mikusnt/M.O.C./Eagle/MOC/moc.brd

## EAGLE design Eagle/MOC/moc.brd (2019-04-15)

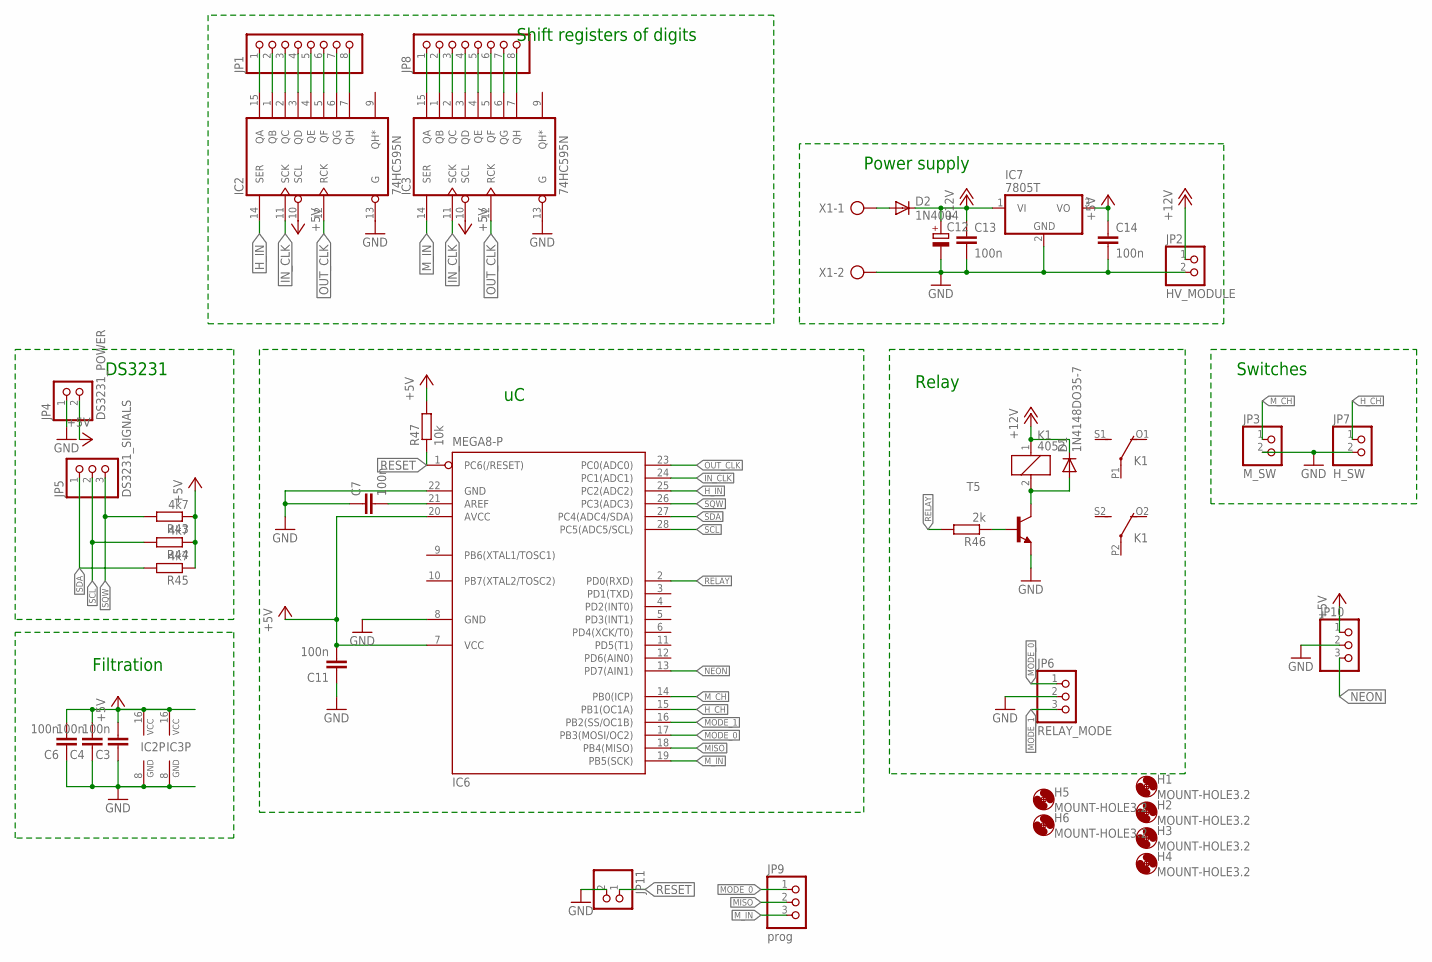
[picture p1: schematic moc.sch]

Parts:
C3, C4, C6, C7, C11, C13, C14: 100n; C025-025X050
C12: CPOL-EUE3.5-8; E3,5-8
D1: 1N4148DO35-7; DO35-7
D2: 1N4004; DO41-10
H1, H2, H3, H4, H5, H6: MOUNT-HOLE3.2; 3,2
IC2, IC3: 74HC595N; DIL16
IC6: MEGA8-P; DIL28-3
IC7: 7805T; TO220H
JP1, JP8: PINHD-1X8; 1X08
JP2: HV_MODULE; 1X02
JP3: M_SW; 1X02
JP4: DS3231_POWER; 1X02
JP5: DS3231_SIGNALS; 1X03
JP6: RELAY_MODE; 1X03
JP7: H_SW; 1X02
JP9: prog; 1X03
JP10: PINHD-1X3; 1X03
JP11: PINHD-1X2/90; 1X02/90
K1: 4052; F4052
R43, R44, R45: 4k7; 0207/10
R46: 2k; 0207/7
R47: 10k; 0207/10
T5: BC337-16-NPN-TO92-CBE; TO92-CBE
X1: AK300/2

Connections:
+5V: C3.2, C4.2, C6.2, C11.2, C14.1, IC2.10 (SCL), IC2.16 (VCC), IC3.10 (SCL), IC3.16 (VCC), IC6.7 (VCC), IC6.20 (AVCC), IC7.3 (VO), JP4.2, JP10.1, R43.1, R44.1, R45.1, R47.2
+12V: C12.+, C13.1, D1.C, D2.C, IC7.1 (VI), JP2.1, K1.1
D8: IC3.7 (QH), JP8.8
D9: IC3.6 (QG), JP8.7
D10: IC3.5 (QF), JP8.6
D11: IC3.4 (QE), JP8.5
D12: IC3.3 (QD), JP8.4
D13: IC3.2 (QC), JP8.3
D14: IC3.1 (QB), JP8.2
D15: IC3.15 (QA), JP8.1
D16: IC2.7 (QH), JP1.8
D17: IC2.6 (QG), JP1.7
D18: IC2.5 (QF), JP1.6
D19: IC2.4 (QE), JP1.5
D20: IC2.3 (QD), JP1.4
D21: IC2.2 (QC), JP1.3
D22: IC2.1 (QB), JP1.2
D23: IC2.15 (QA), JP1.1
GND: C3.1, C4.1, C6.1, C7.1, C11.1, C12.-, C13.2, C14.2, IC2.8 (GND), IC2.13 (G), IC3.8 (GND), IC3.13 (G), IC6.8 (GND), IC6.22 (GND), IC7.2 (GND), JP2.2, JP3.2, JP4.1, JP6.2, JP7.2, JP10.2, JP11.2, T5.E, X1.2
H_CH: IC6.15 (PB1(OC1A)), JP7.1
H_IN: IC2.14 (SER), IC6.25 (PC2(ADC2))
IN_CLK: IC2.11 (SCK), IC3.11 (SCK), IC6.24 (PC1(ADC1))
MISO: IC6.18 (PB4(MISO)), JP9.2
MODE_0: IC6.17 (PB3(MOSI/OC2)), JP6.1, JP9.1
MODE_1: IC6.16 (PB2(SS/OC1B)), JP6.3
M_CH: IC6.14 (PB0(ICP)), JP3.1
M_IN: IC3.14 (SER), IC6.19 (PB5(SCK)), JP9.3
unnamed: D2.A, X1.1
unnamed: C7.2, IC6.21 (AREF)
unnamed: D1.A, K1.2, T5.C
unnamed: R46.1, T5.B
NEON: IC6.13 (PD7(AIN1)), JP10.3
OUT_CLK: IC2.12 (RCK), IC3.12 (RCK), IC6.23 (PC0(ADC0))
RELAY: IC6.2 (PD0(RXD)), R46.2
RESET: IC6.1 (PC6(/RESET)), JP11.1, R47.1
SCL: IC6.28 (PC5(ADC5/SCL)), JP5.2, R44.2
SDA: IC6.27 (PC4(ADC4/SDA)), JP5.1, R45.2
SQW: IC6.26 (PC3(ADC3)), JP5.3, R43.2

Notes on the sheet:
DS3231
Relay
Power supply
Filtration
Shift registers of digits
Switches

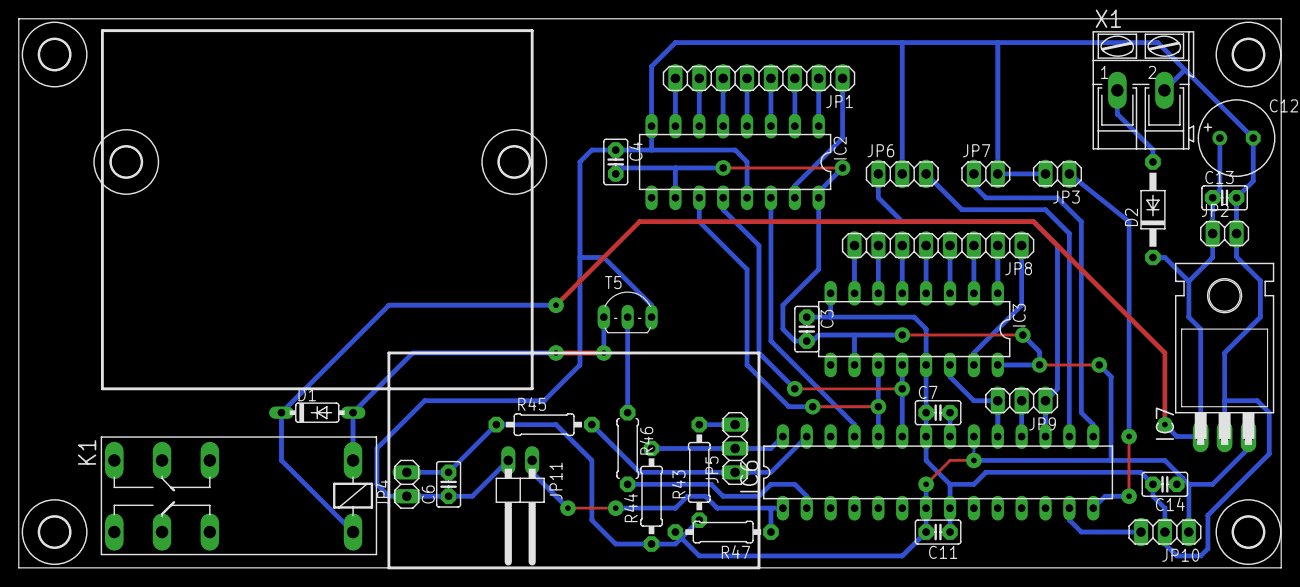
[picture p2: board moc.brd from above]

Board: 2 copper layers, 134.3 x 58.4 mm, 39 parts (0 on the bottom side), 38 nets.
