mikusnt/M.O.C./Eagle/MOC/moc2.brd

## EAGLE design Eagle/MOC/moc2.brd (2019-03-03)

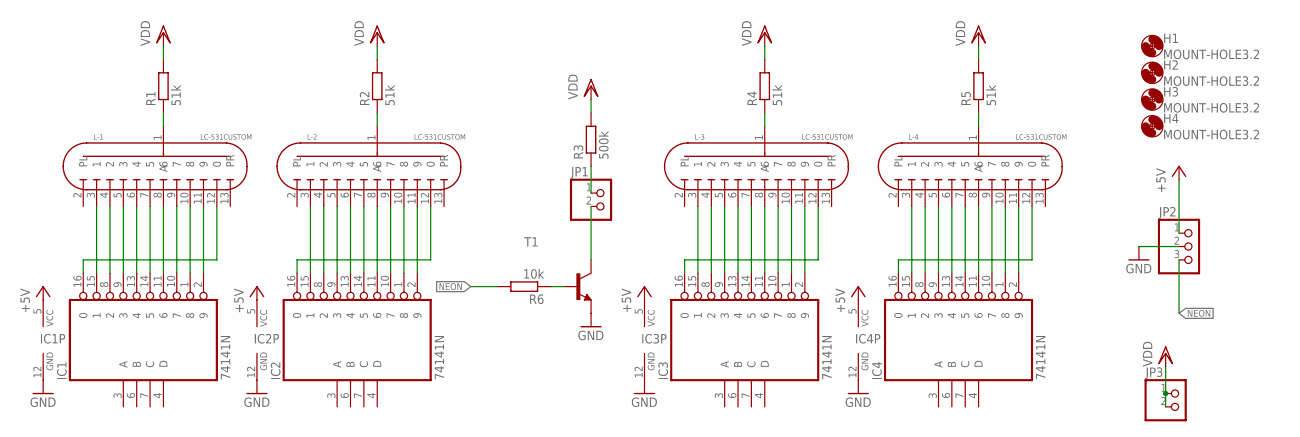
[picture p3: schematic moc2.sch]

Parts:
H1, H2, H3, H4: MOUNT-HOLE3.2; 3,2
IC1, IC2, IC3, IC4: 74141N; DIL16
JP1: PINHD-1X2; 1X02
JP2: PINHD-1X3/90; 1X03/90
JP3: PINHD-1X2/90; 1X02/90
L-1, L-2, L-3, L-4: LC-531CUSTOM; LC-531_PIN_SOCKET
R1, R2, R4, R5: 51k; 0207/10
R3: 500k; 0207/10
R6: 10k; 0207/10
T1: BF422-NPN-TO92-BCE; TO92-BCE

Connections:
+5V: IC1.5 (VCC), IC2.5 (VCC), IC3.5 (VCC), IC4.5 (VCC), JP2.1
GND: IC1.12 (GND), IC2.12 (GND), IC3.12 (GND), IC4.12 (GND), JP2.2, T1.E
unnamed: IC1.15 (1), L-1.3 (1)
unnamed: IC1.8 (2), L-1.4 (2)
unnamed: IC1.9 (3), L-1.5 (3)
unnamed: IC1.13 (4), L-1.6 (4)
unnamed: IC1.14 (5), L-1.7 (5)
unnamed: IC1.11 (6), L-1.8 (6)
unnamed: IC1.10 (7), L-1.9 (7)
unnamed: IC1.1 (8), L-1.10 (8)
unnamed: IC1.2 (9), L-1.11 (9)
unnamed: IC1.16 (0), L-1.12 (0)
unnamed: L-1.1 (A), R1.1
unnamed: IC2.15 (1), L-2.3 (1)
unnamed: IC2.8 (2), L-2.4 (2)
unnamed: IC2.9 (3), L-2.5 (3)
unnamed: IC2.13 (4), L-2.6 (4)
unnamed: IC2.14 (5), L-2.7 (5)
unnamed: IC2.11 (6), L-2.8 (6)
unnamed: IC2.10 (7), L-2.9 (7)
unnamed: IC2.1 (8), L-2.10 (8)
unnamed: IC2.2 (9), L-2.11 (9)
unnamed: IC2.16 (0), L-2.12 (0)
unnamed: L-2.1 (A), R2.1
unnamed: JP1.2, T1.C
unnamed: JP1.1, R3.1
unnamed: IC3.15 (1), L-3.3 (1)
unnamed: IC3.8 (2), L-3.4 (2)
unnamed: IC3.9 (3), L-3.5 (3)
unnamed: IC3.13 (4), L-3.6 (4)
unnamed: IC3.14 (5), L-3.7 (5)
unnamed: IC3.11 (6), L-3.8 (6)
unnamed: IC3.10 (7), L-3.9 (7)
unnamed: IC3.1 (8), L-3.10 (8)
unnamed: IC3.2 (9), L-3.11 (9)
unnamed: IC3.16 (0), L-3.12 (0)
unnamed: L-3.1 (A), R4.1
unnamed: IC4.15 (1), L-4.3 (1)
unnamed: IC4.8 (2), L-4.4 (2)
unnamed: IC4.9 (3), L-4.5 (3)
unnamed: IC4.13 (4), L-4.6 (4)
unnamed: IC4.14 (5), L-4.7 (5)
unnamed: IC4.11 (6), L-4.8 (6)
unnamed: IC4.10 (7), L-4.9 (7)
unnamed: IC4.1 (8), L-4.10 (8)
unnamed: IC4.2 (9), L-4.11 (9)
unnamed: IC4.16 (0), L-4.12 (0)
unnamed: L-4.1 (A), R5.1
unnamed: R6.1, T1.B
NEON: JP2.3, R6.2
VDD: JP3.1, JP3.2, R1.2, R2.2, R3.2, R4.2, R5.2

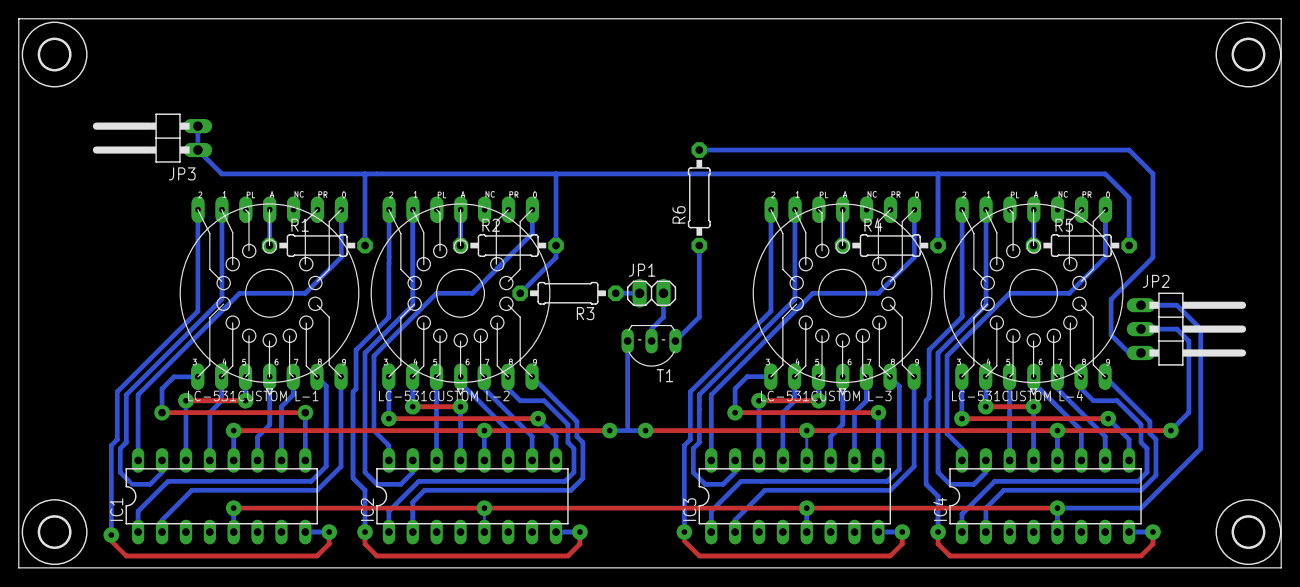
[picture p4: board moc2.brd from above]

Board: 2 copper layers, 134.3 x 58.4 mm, 22 parts (0 on the bottom side), 51 nets.
