mikusnt/M.O.C./todo.md

## Basic Tasks
- [x] project structure
- [x] Eagle schematics
- [x] buying parts
- [ ] design of case
- [x] basic functionality
- [x] rename digits slowly
- [x] hardware tests
- [x] all cathodes heat on

## Extended Tasks  
- [x] some modes of relay
- [ ] chroma steel case
