mikusnt/M.O.C./devices/relay.c

/*!
 * @file relay.c
 * @author 		Mikolaj Stankowiak <br>
 * 				mik-stan@go2.pl
 * @see relay.h*/

#include "relay.h"

uint8_t eeRelayState EEMEM = RelaySilent;

/*
 *
 *		Internal functions
 *
 */

static void RelayReset(volatile Relay *r) {
	r->ui16ActTimeMS = 0;
	r->uiByteInfo = 0;
	r->uiByteLength = 0;
	r->ui16StartTimeMS = 0;
	r->ui16StartLength = 0;
	r->bWithData = false;
}
/*! change hardware relay state
 * @param 		eB logic state of relay*/
static inline void RelaySW(BinarySwitch eB) {
	if (eB) RELAY_PORT |= RELAY_ADDR;
	else RELAY_PORT &= ~RELAY_ADDR;
}


/*! zamienia kolejnosc bitow w bajcie na przeciwna
 * rounding bit order to opposite
 * @param 		byte to round
 * @param 		uiByteLength_s length of rounded byte
 * @return 		byte after rounded*/
static inline uint8_t RoundByte(uint8_t byte, volatile uint8_t *uiByteLength_s) {
	uint8_t temp = 0;
	if (byte) {
		*uiByteLength_s = 8;
		temp |= ((byte & 0x80) >> 7) | ((byte & 0x01) << 7);
		temp |= ((byte & 0x40) >> 5) | ((byte & 0x02) << 5);
		temp |= ((byte & 0x20) >> 3) | ((byte & 0x04) << 3);
		temp |= ((byte & 0x10) >> 1) | ((byte & 0x08) << 1);

		while (!(temp % 2)) {
			temp >>= 1;
			(*uiByteLength_s)--;
		}
		return temp;
	} else {
		*uiByteLength_s = 1;
		return 0;
	}
} // END static inline uint8_t RoundByte

/*
 *
 *		External functions
 *
 */
/*! configure relay addess to out*/
void RelayInit(volatile Relay *r) {
	RELAY_DDR |= RELAY_ADDR;
	// read state from eeprom
	r->eState = eeprom_read_byte(&eeRelayState);
}

/*!@param 		relay pointer of relay structure
 * @param 		uiByteInfo data byte to click
 * @param 		dataType type of byte*/
void RelayTimeClicking(volatile Relay *relay, uint8_t uiByteInfo, RelayDataType dataType) {
	if (relay->eState != RelayOFF) {

		// load data to structure
		relay->bWithData = true;
		relay->eDataType = dataType;
		switch(dataType) {
			case RelayDataHours: {
				while (uiByteInfo > 12) uiByteInfo -= 12;
				if (uiByteInfo == 12) uiByteInfo = 0;
				// when hour < 2 not do rounding
				if (uiByteInfo < 2) {
					relay->uiByteLength = (uiByteInfo == 0) ? 6 : 1;
					relay->uiByteInfo = uiByteInfo;
				} else {
					relay->uiByteInfo = RoundByte(uiByteInfo, &relay->uiByteLength);
				}
				relay->ui16StartLength = RELAY_START_H_COUNT;
				relay->ui16StartTimeMS = RELAY_HIGH_START_MS_HOUR;
			} break;
			case RelayDataMinutes: {
				while (uiByteInfo >= 60) uiByteInfo -= 60;
				if (uiByteInfo > 0)
					relay->uiByteInfo = RoundByte(uiByteInfo / 15, &relay->uiByteLength);
				relay->ui16StartLength = RELAY_START_M_COUNT;
				relay->ui16StartTimeMS = RELAY_HIGH_START_MS_MINUTE;
			} break;
			case RelayDataNumber: {
				relay->uiByteInfo = RoundByte(uiByteInfo, &relay->uiByteLength);
				relay->ui16StartLength = RELAY_START_N_COUNT;
				relay->ui16StartTimeMS = RELAY_HIGH_START_MS_NUMBER;
			}
		}

		relay->ui16ActTimeMS = 1;
		RelayTryClickMS(relay);
	} else {
		RelaySW(OFF);
	}
} // END void RelayStartClicking

/*! realize clicking relay from uiByteInfo when time was decrement to 0 while uiByteLength is not empty
 * @param 		relay pointer of relay structure
 * @see 		RelayStartClicking()*/
void RelayTryClickMS(volatile Relay *relay) {
	// works where length of information not equals 0
	if (relay->uiByteLength){
		if (!(--relay->ui16ActTimeMS)) {
			// when start sequence
			if (relay->ui16StartLength) {
					RELAY_CH();
					relay->ui16ActTimeMS = relay->ui16StartTimeMS;
				// rename to pause
				if (--relay->ui16StartLength == 0) {
					RelaySW(LOW);
					if (relay->eDataType != RelayDataMinutes)
						relay->ui16ActTimeMS = RELAY_START_PAUSE_VALUE_MS;
					else
						relay->ui16ActTimeMS = 0;
				}
			// when data sequence
			} else if (relay->bWithData){
				// when high state init low (next bit)
				if (RELAY_IS_ON()) {
					if(relay->uiByteInfo % 2) {
						relay->ui16ActTimeMS = RELAY_LONG_LOW_TIME;
					} else {
						relay->ui16ActTimeMS = RELAY_SHORT_LOW_TIME;
					}
					relay->uiByteInfo >>= 1;
					relay->uiByteLength--;
				} else {
					// when low state init high
					if(relay->uiByteInfo % 2) {
						relay->ui16ActTimeMS = RELAY_LONG_HIGH_TIME;
					} else {
						relay->ui16ActTimeMS = RELAY_SHORT_HIGH_TIME;
					}
				}
				RELAY_CH();
			}
		}
	} else {
		RelaySW(OFF);
		relay->bWithData = false;
	}
} // END void RelayTryClickMS

/*! change relay state and save state to eeprom
 *  @param			relay pointer of relay structure
 *  @param 			eState new relay state */
void SetRelayState(volatile Relay *relay, RelayMode eState) {
	if (relay->eState != eState) {
		relay->eState = eState;
		// save to eeprom
		eeprom_update_byte(&eeRelayState, eState);
		if (eState == RelayOFF) {
			RelayReset(relay);
		}
	}
} // END void SetRelayState


//! @param		relay pointer of relay structure
//! @param		ui16TimeMS time of click in milliseconds
//! @param		uiNumber number of clicks
void RelayClicking(volatile Relay *relay, uint16_t ui16TimeMS, uint8_t uiNumber) {
	if (relay->eState != RelayOFF) {
		RelayReset(relay);
		relay->ui16ActTimeMS = 1;
		relay->ui16StartLength = uiNumber * 2;
		relay->uiByteLength = 1;
		relay->bWithData = false;

		relay ->ui16StartTimeMS = ui16TimeMS;

		RelayTryClickMS(relay);
	}
} // END void RelayClicking

void RelayTest(volatile Relay *relay, bool bForeverLoop) {
	while(1) {
		RelayClicking(relay, 100, 3);
		D_S(5);
		RelayClicking(relay, 1000, 3);
		D_S(5);

		uint8_t i;
		for(i = 0; i < 5; i++) {
			RelayTimeClicking(relay, i, RelayDataHours);
			D_S(10);

		}


		for(i = 1; i < 4; i++) {
			RelayTimeClicking(relay, i * 15, RelayDataMinutes);
			D_S(5);
		}



		RelayTimeClicking(relay, 240, RelayDataNumber);
		D_S(10);
		if (!bForeverLoop){
			break;
		}
	}
} // END void RelayTest()
