mikusnt/M.O.C./devices/register.c

/*!
 * @file register.c
 * @author 		Mikolaj Stankowiak <br>
 * 				mik-stan@go2.pl
 * @see register.h*/

#include "register.h"


/*! initialize IO registers to work which 74HC595*/
void RegistersInit() {
	/*Y_DATA_DDR |= Y_DATA_ADDR;
	Y_CLK_DATA_DDR |= Y_CLK_DATA_ADDR;
	Y_RESET_DDR |= Y_RESET_ADDR;*/

	LATCH_DDR |= LATCH_ADDR;
	//Y_ON();

	SECOND_DATA_DDR |= SECOND_DATA_ADDR;
	FIRST_DATA_DDR |= FIRST_DATA_ADDR;
	if (WITH_SECONDS)
		THIRD_DATA_DDR |= THIRD_DATA_ADDR;
	//S_DATA_DDR |= S_DATA_ADDR;
	TIME_CLK_DATA_DDR |= TIME_CLK_DATA_ADDR;

	ClearRegistersTime(true);
} // END void RegistersInit

void RegistersTest(bool bForeverLoop) {
	RegistersInit();
	uint8_t i;
	uint16_t time = 1000;
	SendRegistersTime(0, 0, 0, true);
	D_MS(time);
	while(1) {
		if (WITH_SECONDS) {
			for (i = 1; i < 10; i++) {
				SendRegistersTime(0, 0, i, true);
				D_MS(time);
			}

			for (i = 1; i < 10; i++) {
				SendRegistersTime(0, 0, (i * 10) + 9, true);
				D_MS(time);
			}

		}

		for (i = 1; i < 10; i++) {
			SendRegistersTime(0, i, 99, true);
			D_MS(time);
		}

		for (i = 1; i < 10; i++) {
			SendRegistersTime(0, (i * 10) + 9, 99, true);
			D_MS(time);
		}

		for (i = 1; i < 10; i++) {
			SendRegistersTime(i, 99, 99, true);
			D_MS(time);
		}

		for (i = 1; i < 10; i++) {
			SendRegistersTime((i * 10) + 9, 99, 99, true);
			D_MS(time);
		}
		if (!bForeverLoop)
			break;
	}
} // END void RegistersTest()
