mikusnt/M.O.C./devices/some_devices.c

/*!
 * @file some_devices.c
 * @author 		Mikolaj Stankowiak <br>
 * 				mik-stan@go2.pl
 * @see other_devices.h*/

#include "some_devices.h"

void ButtonsInit() {
	HOUR_DDR &= ~HOUR_ADDR; // pull up resistors and input mode
	HOUR_PORT |= HOUR_ADDR;

	MINUTE_DDR &= ~MINUTE_ADDR;
	MINUTE_PORT |= MINUTE_ADDR;

	RM_DDR &= ~RM_ADDR;
	RM_PORT |= RM_ADDR;
} // END void ButtonsInit

//! 1ms period
void Timer2Init() {
	// tryb CTC
	TCCR2A |= (1 << WGM21);
	// 8 MHz preskaler 32 OCR2A = 250, 1 MHz preskaler 32 OCR2A = 25
	TCCR2B |= (1 << CS21) | (1 << CS20);
	// odblokowanie przerwan
	TIMSK2 |= (1 << OCIE2A);
	// preskaler 32
	OCR2A = 25;
} // END void Timer2Init

void PCINTInit() {
	SQW_DDR &= ~SQW_ADDR;

	PCICR |= (1 << PCIE1); // unlock interrupt group 8-14 and 16-23
	PCMSK1 |= (1 << PCINT11); // SQW
	//PCMSK2 |= (1 << PCINT23); // Bluetooth
} // END void PCINTInit()

void NeonInit() {
	NEON_DDR |= NEON_ADDR;
	NEON_PORT &= ~NEON_ADDR; // start with 0
} // END void PointInit()

void PowerReduction() {
	PRR |= (1 << PRTIM1); // turn off Timer1
}

void NeonTest() {
	while(1) {
		NeonRename();
		D_S(1);
	}
} // END void PointTest
