mikusnt/M.O.C./(commit log)

2018-11-17 simple mainboard schematic
    [moc.brd, moc.sch]
2019-03-02 relay in main file, code of tests
2019-03-03 hardware tests, all features
    [moc.brd, moc.sch, moc2.brd, moc2.sch]
2019-04-15 cathodes heat on mode, relay parameters
    [moc.brd, moc.sch]
2019-08-13 universal second register switch
2019-08-13 1MHz freq and two modes of relay mode buttons
2021-01-07 only one mode of relay, lamp diagnostic mode by press two buttons
